jeby/RaceChronoDiyBleDevice/images/board_obd_box.jpg

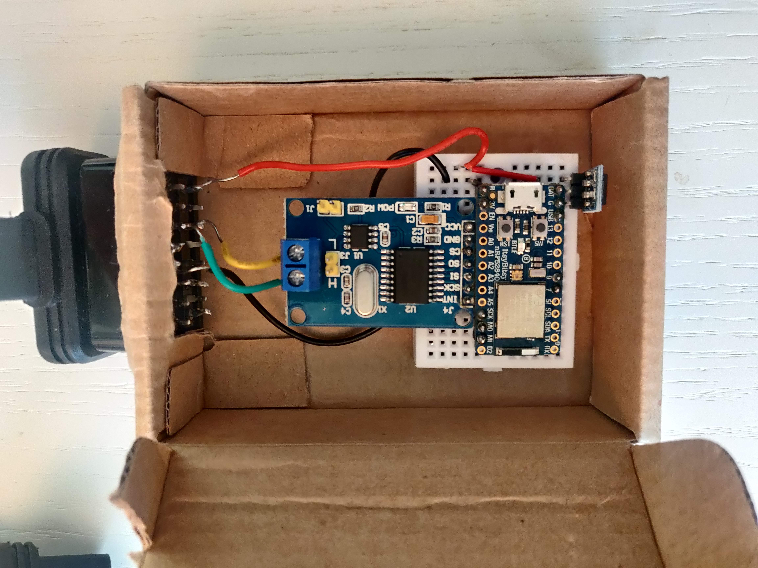
[picture p7: images/board_obd_box.jpg]
images/board_obd_box.jpg
